g200kg/strober/docs/StroberSchematic.pdf

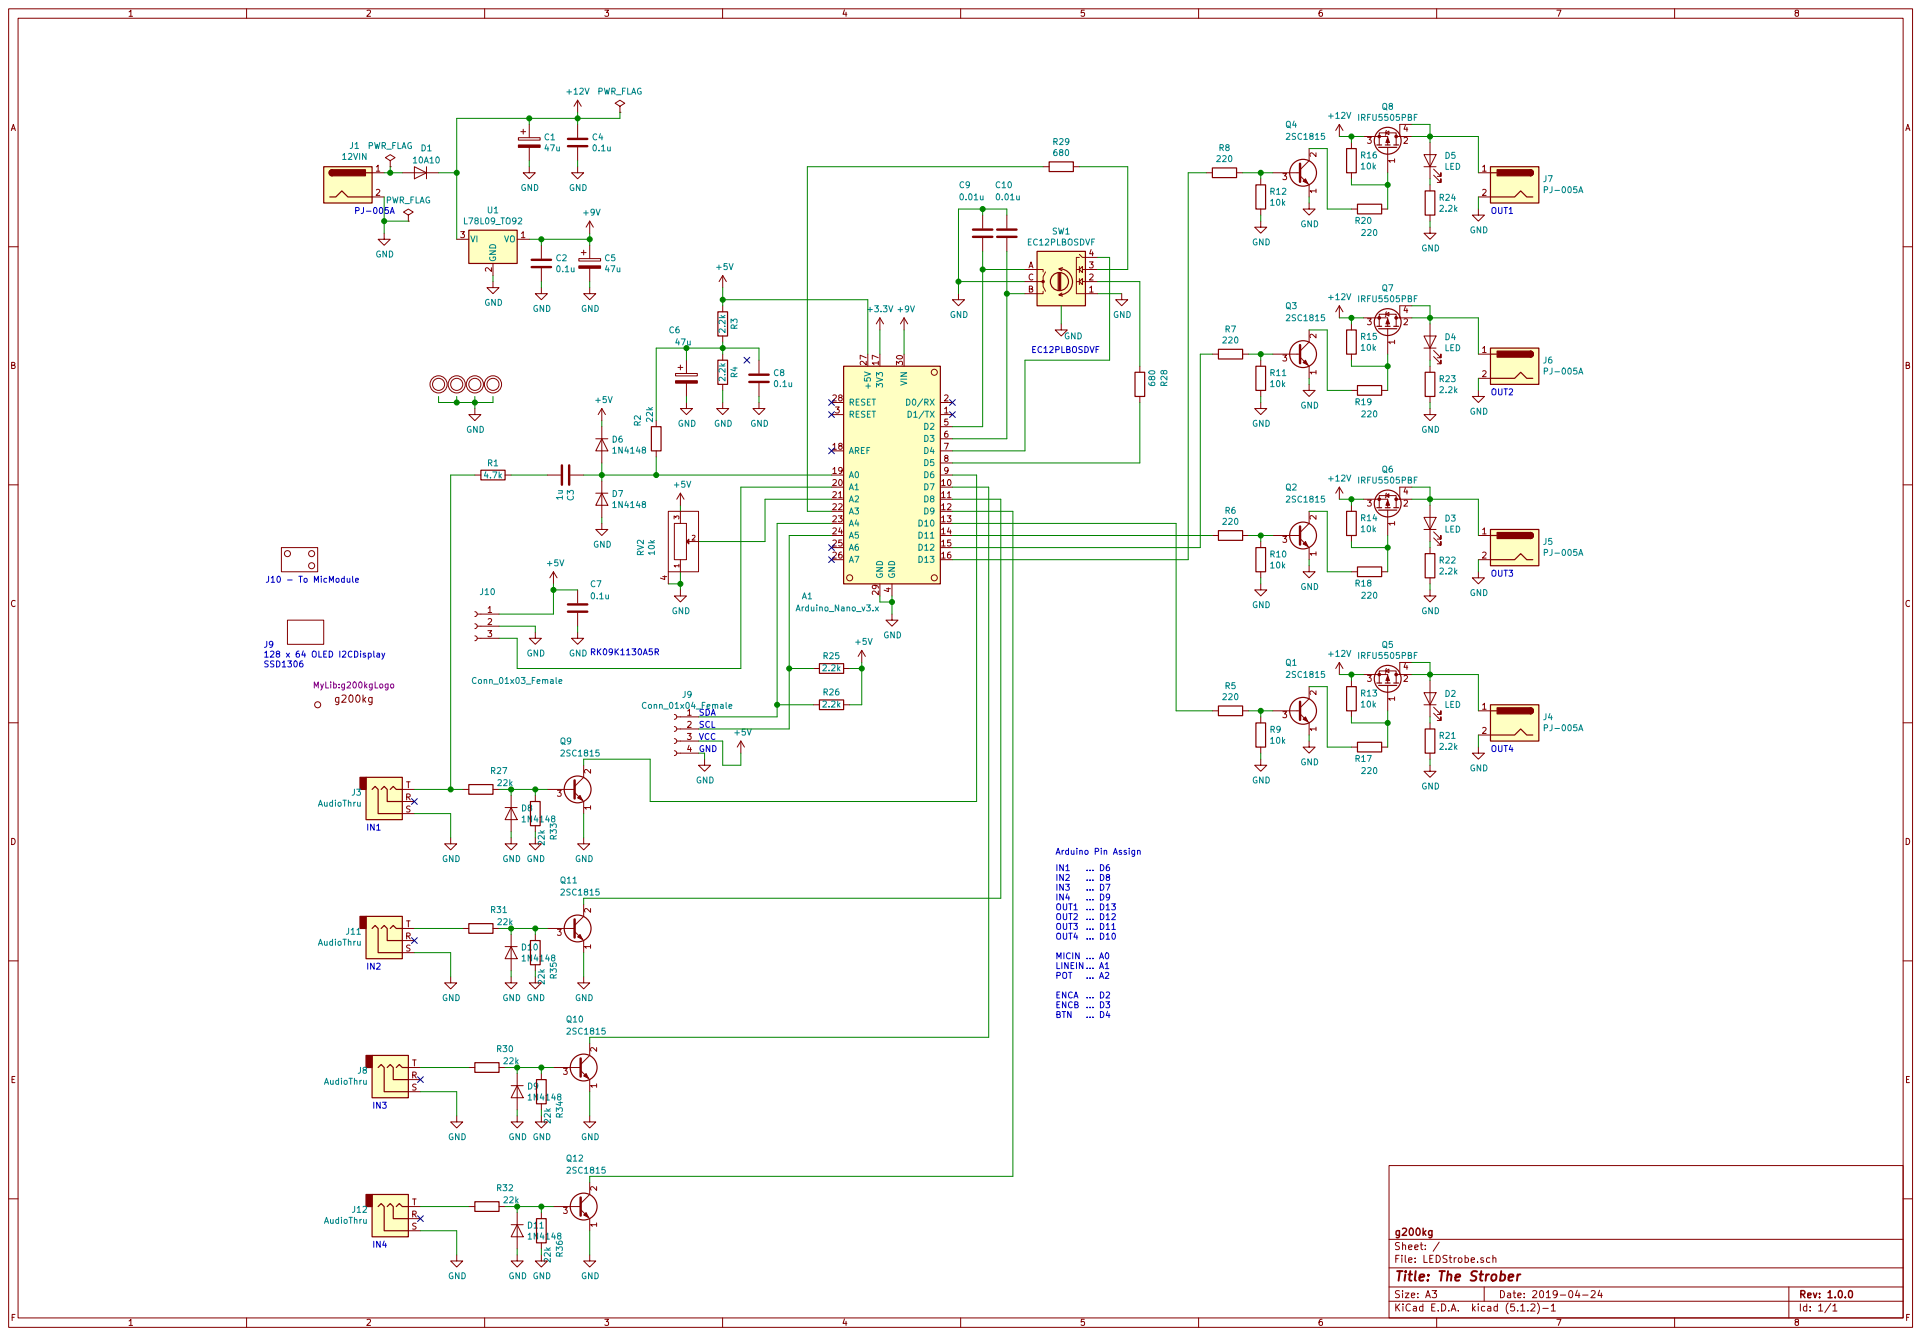
[picture p2: page 1]

PWR_FLAG
Id: 1/1 Title: The Strober File: LEDStrobe.sch Sheet: / g200kg 12
